ICE9-Robotics/MONA_ESP_hardware/README.md

# MONA-ESP hardware
A repo containing all the hardware files for the ESP-MONA swarm research and educational robotic platform

A full software library and examples compatible with Arduino IDE have been provided. Go to [MONA_ESP_lib](https://github.com/ICE9-Robotics/MONA_ESP_lib) to obtain the library files and installation instructions.
