ICE9-Robotics/MONA_ESP_hardware/hardware/README.md

# MONA ESP Hardware

## Schematic
The schematic for the board is given in a PDF file. The value of passive components is shown and the component code of the IC. 

## PCB design file
The PCB board file is given in [KiCad](https://www.kicad.org) format. It is neccesarry to use KiCad to open the board file.

## MONA ESP board design
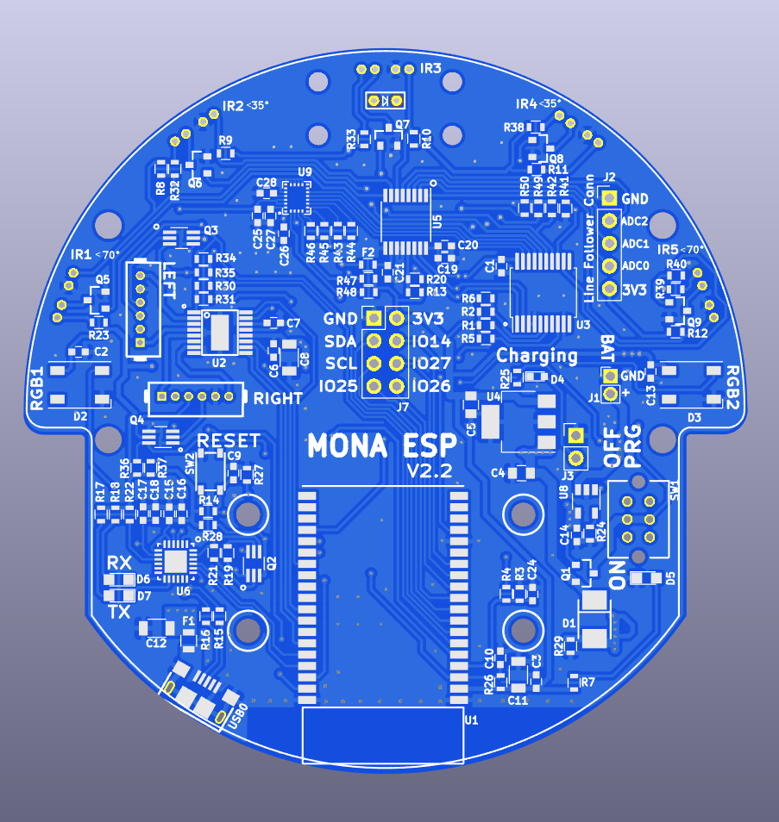
[picture p1: hardware/MONA_ESP_V2_2-Board.png]
