ICE9-Robotics/MONA_ESP_hardware/hardware/CAD/README.md

3D CAD files for the 3D printed parts of the MONA
Recommended Print Settings:
Material: PLA
Nozzle Size: 0.4 mm
Layer Height: 0.2 mm
Infill: 25%
Perimeters: 2
Support: None

Required 3D Printed Parts for 1 Mona:
- 1 x Mona Front Roller and Battery Mount
- 2 x Mona Motor Mount Base
- 2 x Mona Motor Mount Cap
- 2 x Mona Wheel
or 
- 1 x Mona All Parts
