ICE9-Robotics/MONA_ESP_hardware/hardware/CAD/Mona Assembly Printing File.3mf

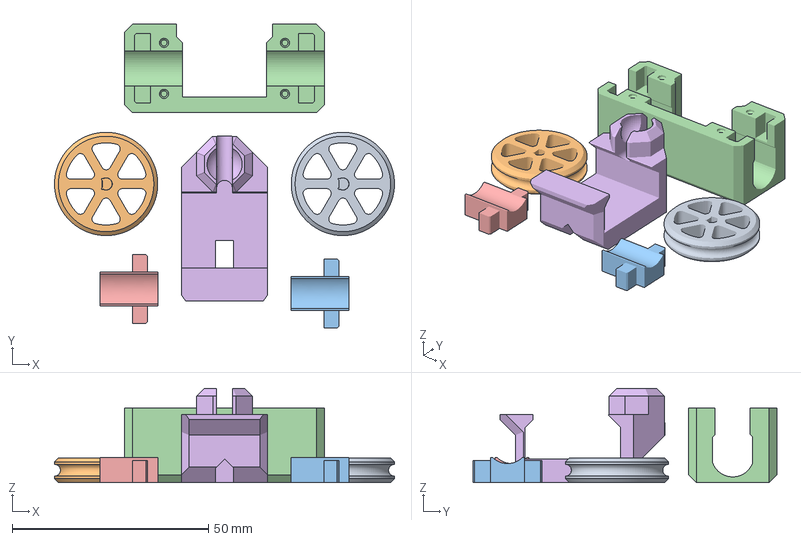
[picture p2: CAD file, 2025-12-02]
hardware/CAD/Mona Assembly Printing File.3mf
86.6 x 77.3 x 24.0 mm
Mona Wheel.stl x 2
Mona Motor Mount Cap.stl x 2
Mona Motor Mount Base.stl
Mona Front Roller and Battery Mount.stl
