ICE9-Robotics/MONA_ESP_hardware/hardware/CAD/Mona Motor Mount Base.stl

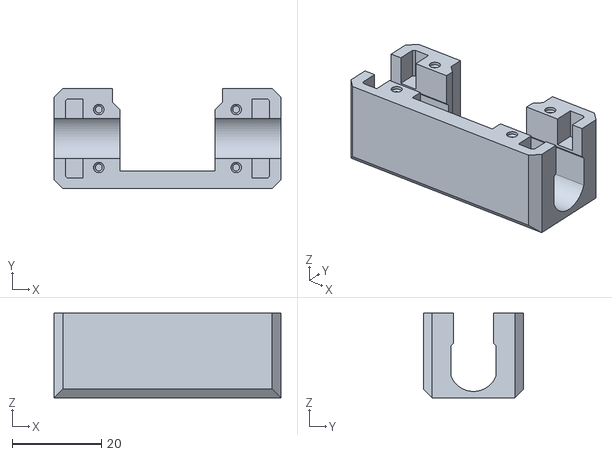
[picture p3: CAD file, 2025-12-02]
hardware/CAD/Mona Motor Mount Base.stl
50.9 x 22.5 x 19.0
