ICE9-Robotics/MONA_ESP_hardware/hardware/CAD/Mona Motor Mount Cap.stl

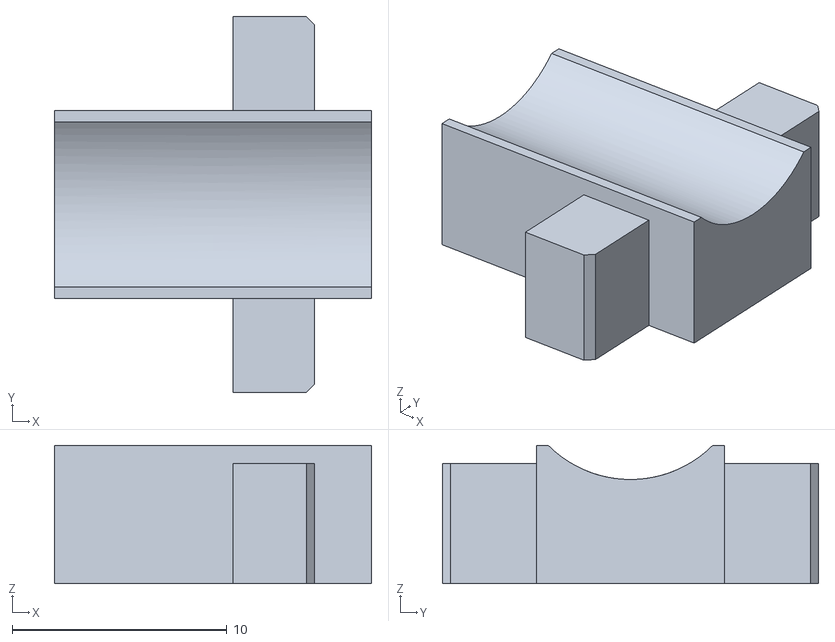
[picture p4: CAD file, 2025-12-02]
hardware/CAD/Mona Motor Mount Cap.stl
14.8 x 17.5 x 6.44
