ICE9-Robotics/MONA_ESP_hardware/hardware/CAD/Mona Wheel.stl

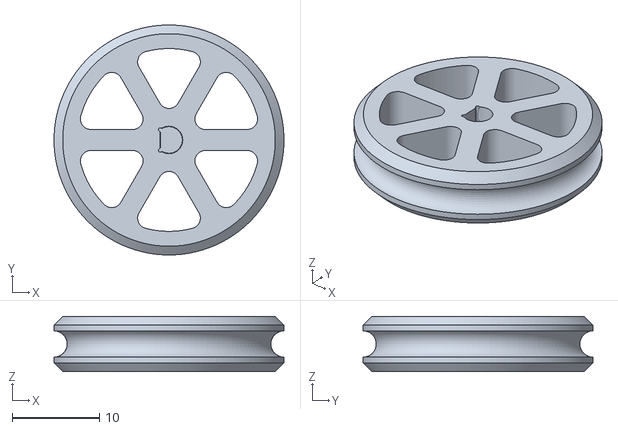
[picture p5: CAD file, 2025-12-02]
hardware/CAD/Mona Wheel.stl
26.3 x 26.3 x 6.30
