ICE9-Robotics/MONA_ESP_hardware/hardware/MONA_ESP_V2_2-Schematic.pdf

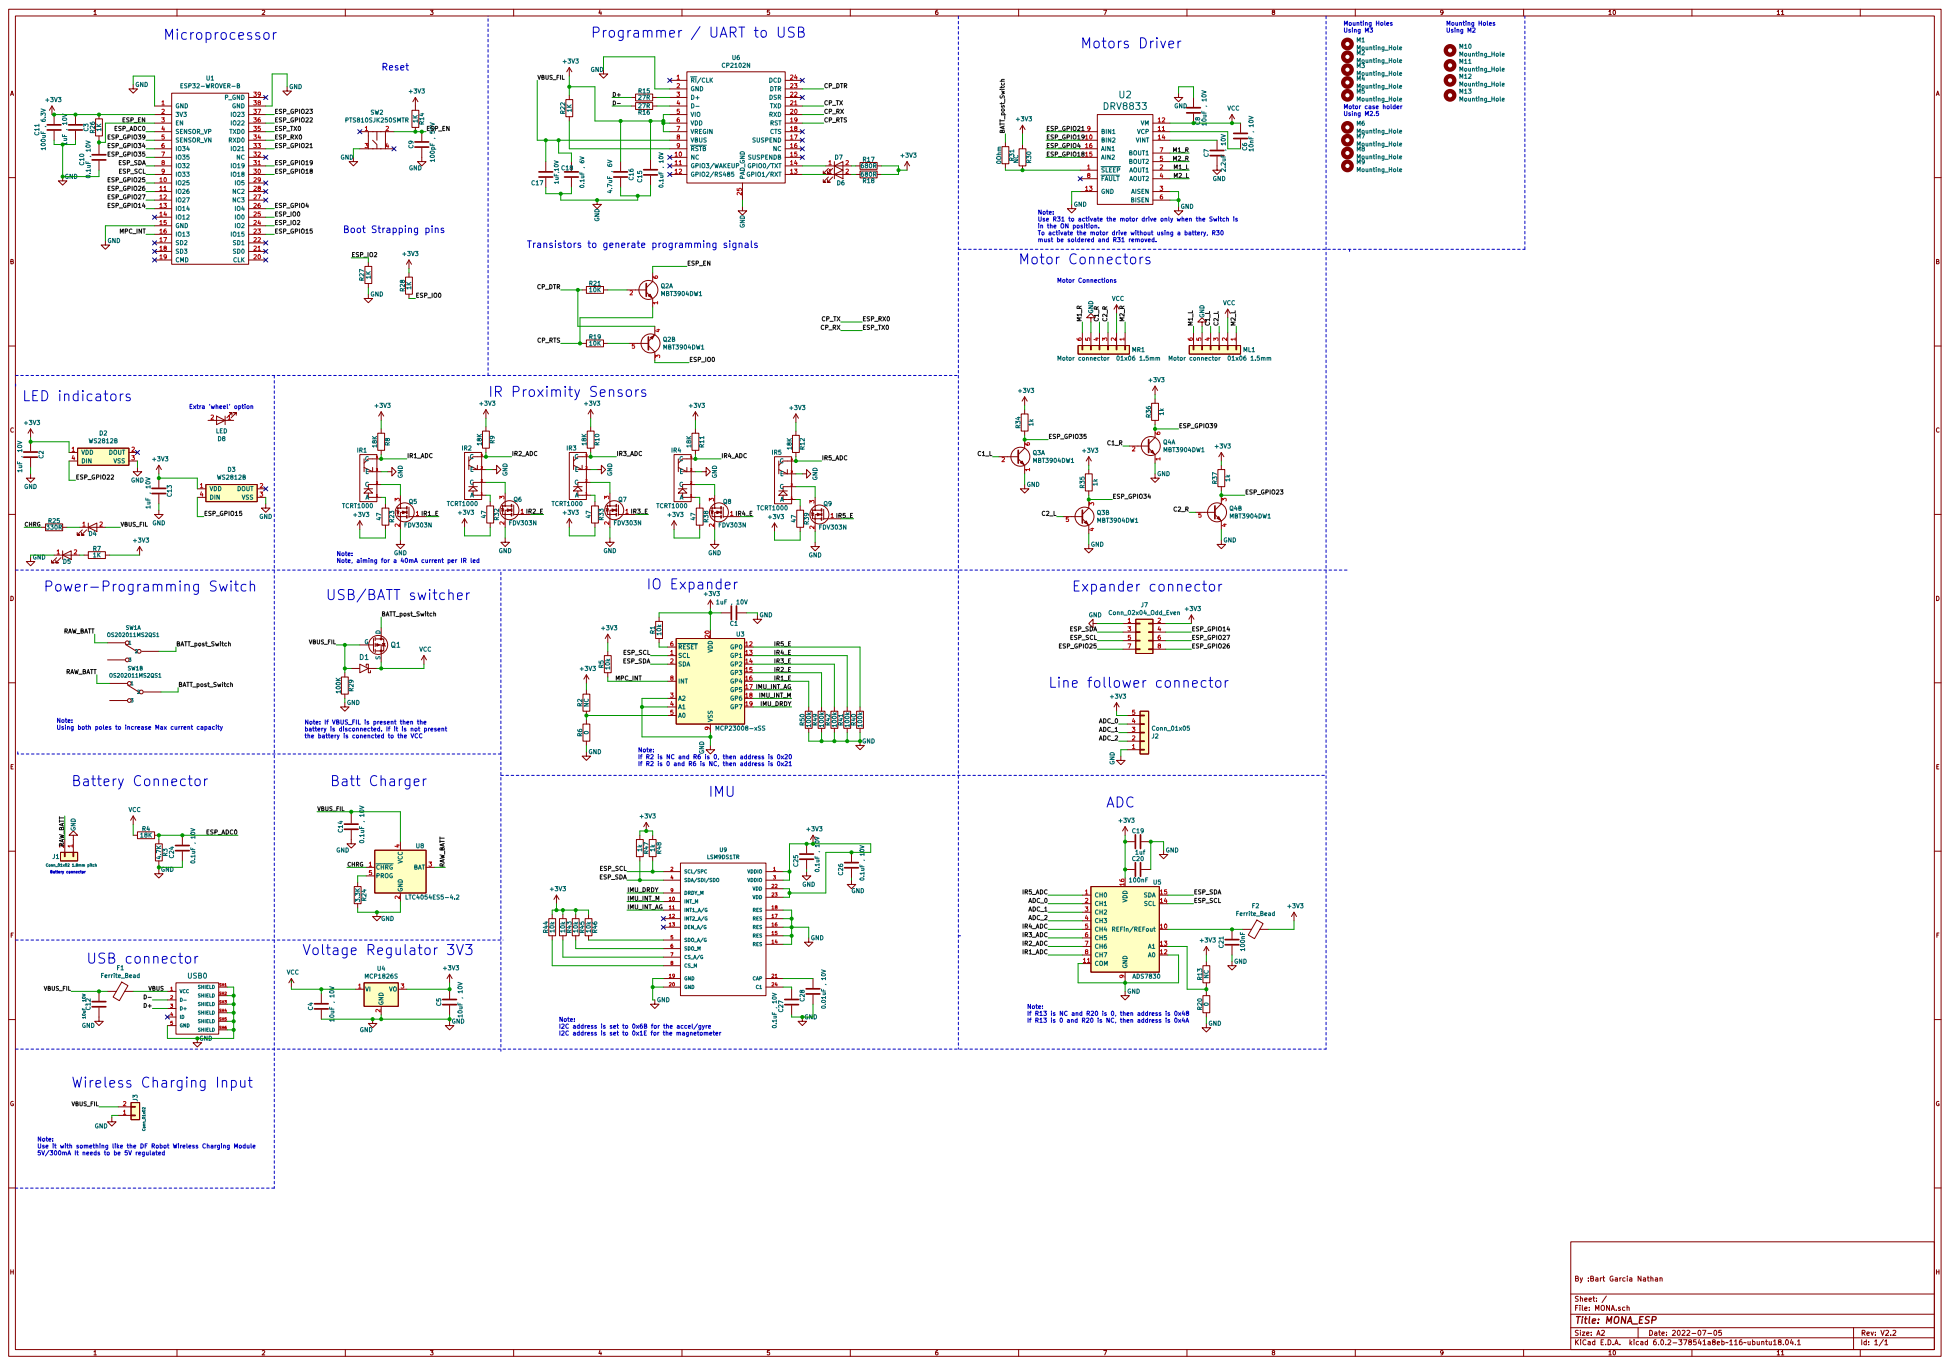
[picture p6: page 1]

Programmer / UART to USB

Note: Use R31 to activate the motor drive only when the Switch is

in the ON position.
Motor Connectors

To activate the motor drive without using a battery, R30 must be soldered and R31 removed. IO Expander

Transistors to generate programming signals

Note: Using both poles to increase Max current capacity

Note: If VBUS_FIL is present then the
battery is disconnected. If it is not present
the battery is conencted to the VCC

Note:
If R2 is NC and R6 is 0, then address is 0x20
If R2 is 0 and R6 is NC, then address is 0x21

If R13 is NC and R20 is 0, then address is 0x48
If R13 is 0 and R20 is NC, then address is 0x4A

I2C address is set to 0x6B for the accel/gyre
I2C address is set to 0x1E for the magnetometer

Note: Use it with something like the DF Robot Wireless Charging Module

5V/300mA It needs to be 5V regulated

File: MONA.sch Sheet: / By :Bart Garcia Nathan
