ICE9-Robotics/MONA_ESP_hardware/hardware/PCB_Design/MONA_ESP_V2_2.kicad_pcb

## KiCad design hardware/PCB_Design/MONA_ESP_V2_2.kicad_pcb (2022-07-05)

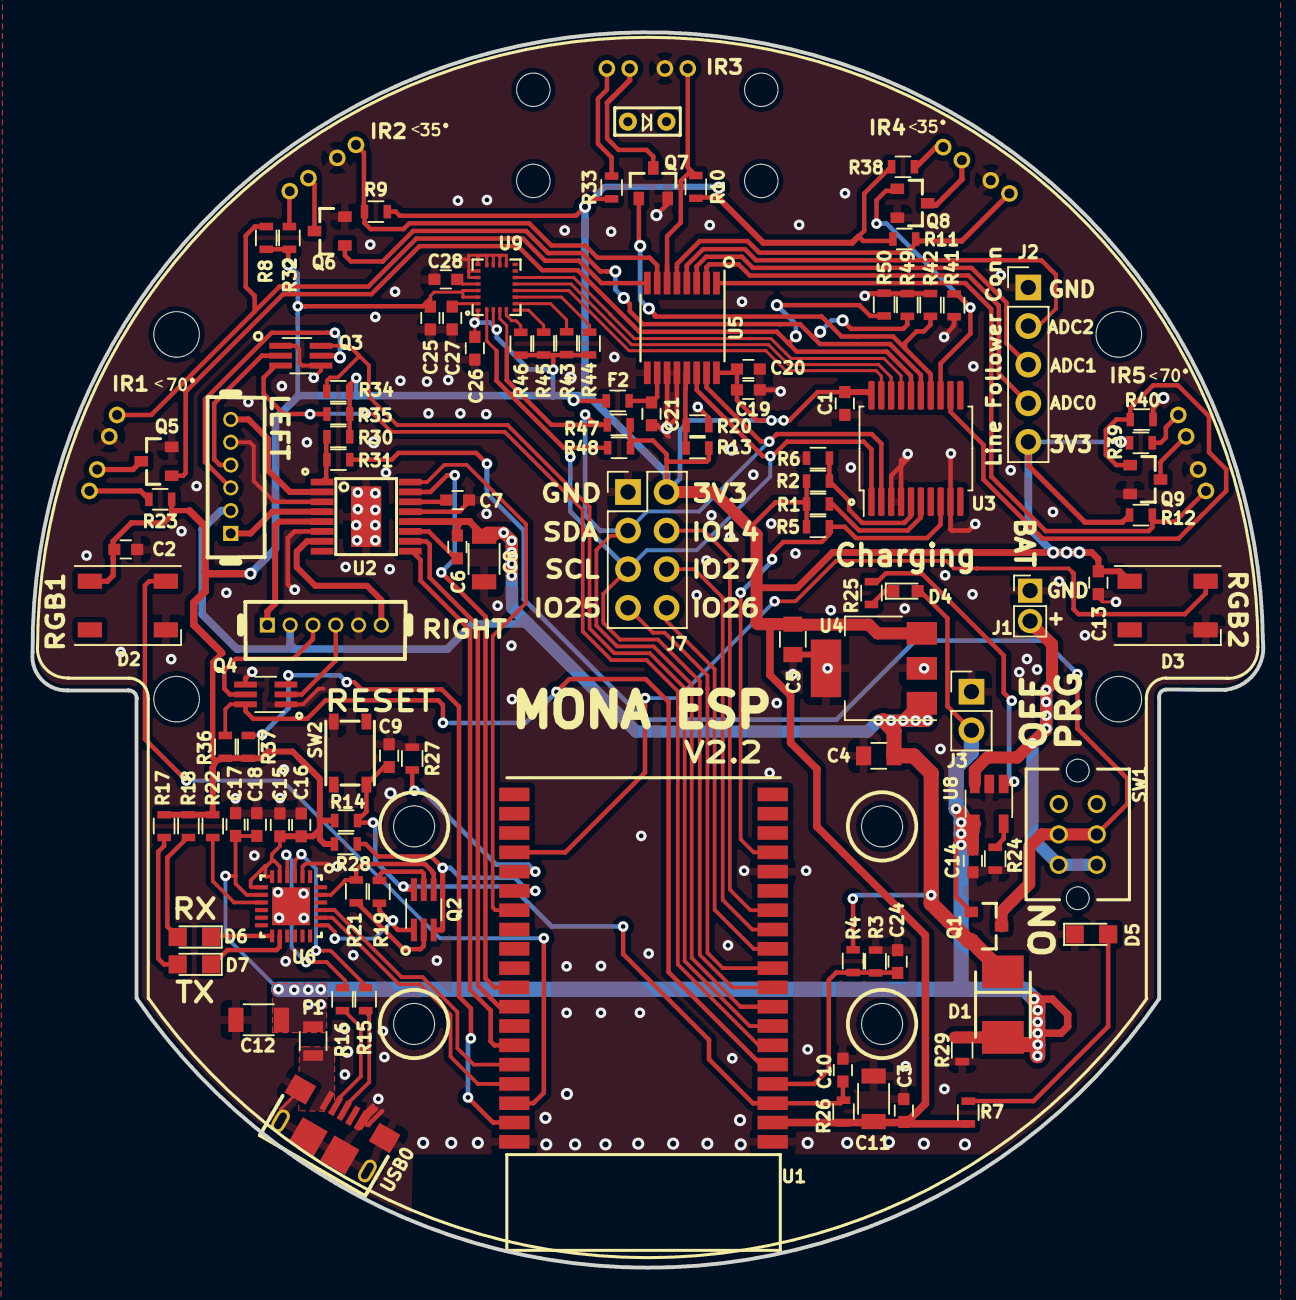
[picture p7: board MONA_ESP_V2_2.kicad_pcb from above]

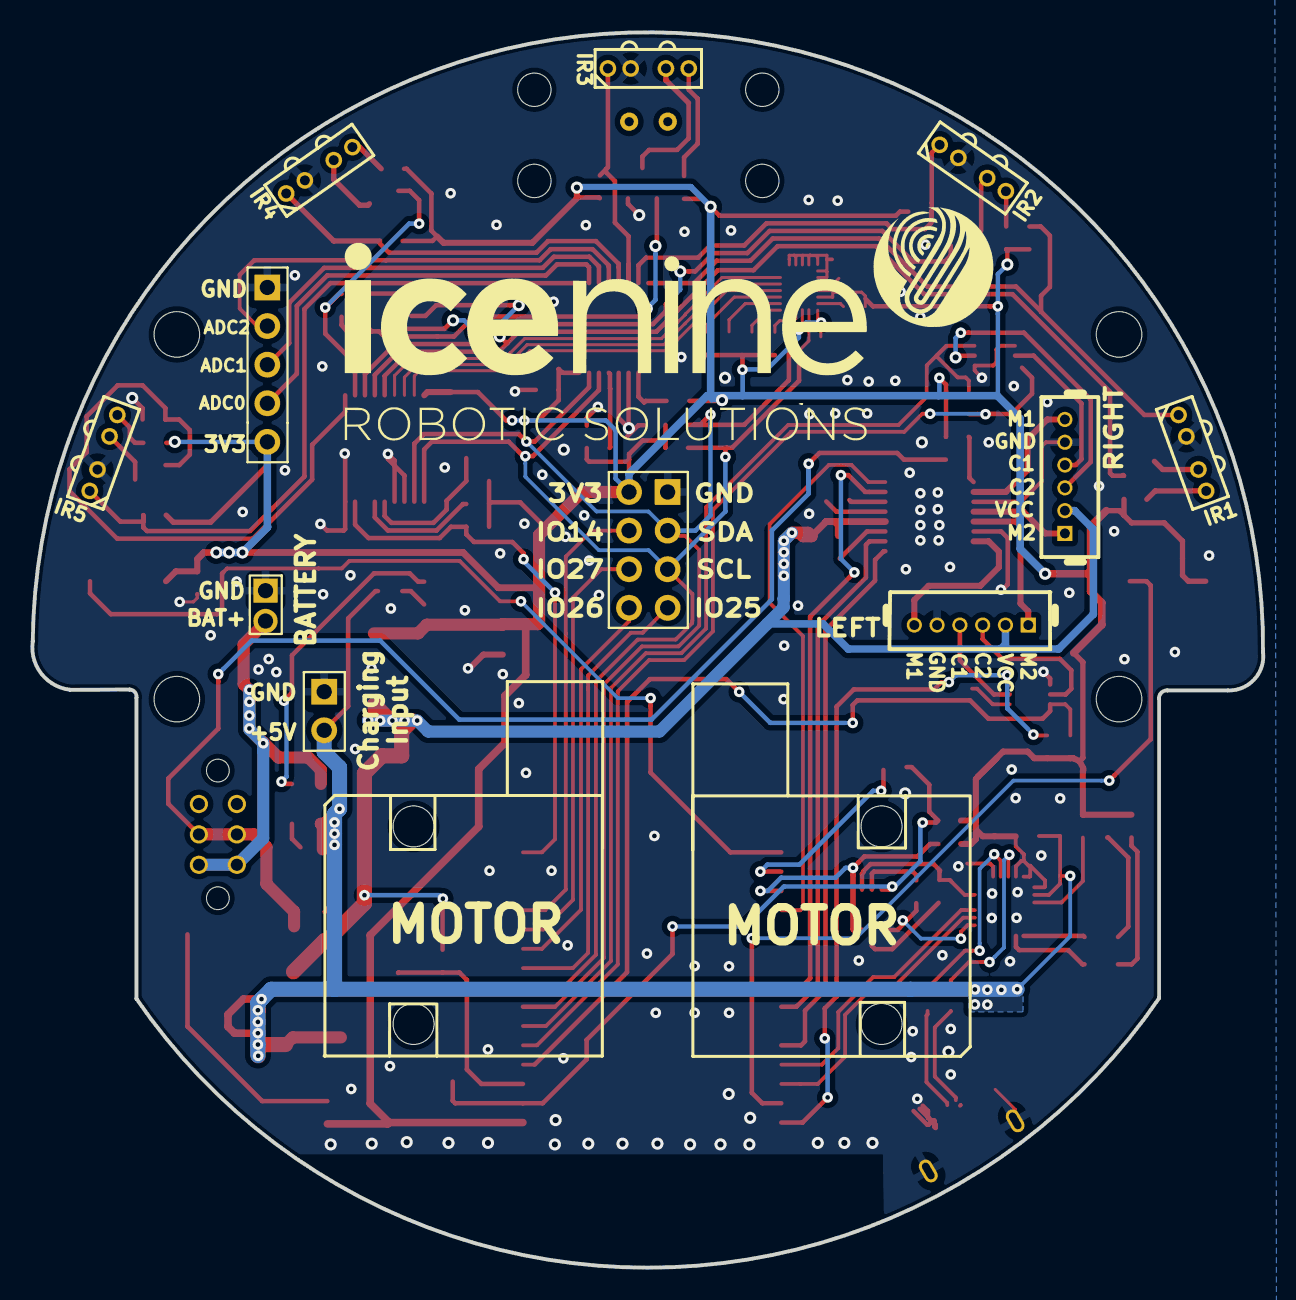
[picture p8: board MONA_ESP_V2_2.kicad_pcb from below]

Board: 2 copper layers, 81.0 x 81.3 mm, 129 parts (5 on the bottom side), 94 nets.

Parts:
C1, C2, C3, C13: 1uF , 10V; C_0603
C4, C5: 10uF , 10V; C_0805
C6: 10nF , 10V; C_0603
C7: 2.2uF , 10V; C_0603
C8, C12: 10uF , 10V; C_1206
C9: 100pF , 50V; C_0603
C10, C14, C15, C24, C25, C26, C27: 0.1uF , 10V; C_0603
C11: 100uF , 6.3V; C_1206
C16: 4.7uF , 6V; C_0603
C17: 1uF,10V; C_0603
C18: 0.1uF , 6V; C_0603
C19: 1uf; C_0603
C20, C21: 100nF; C_0603
C28: 0.01uF , 10V; C_0603
D1: Schottky_403A; SMB_403A
D2, D3: WS2812B; LED_WS2812B-PLCC4
D4: LED; LED_0603
D5, D6, D7, D8: LED; LED_0805
F1: Ferrite_Bead; L_0805
F2: Ferrite_Bead; L_0603
IR1, IR2, IR3, IR4, IR5: TCRT1000
J1: Conn_01x02 1.8mm pitch; BAT_conn_1x02_Pitch1.8mm
J2: Conn_01x05; Pin_Header_Straight_1x05_Pitch2.54mm
J3: Conn_01x02; Pin_Header_Straight_1x02_Pitch2.54mm
J7: Conn_02x04_Odd_Even; Pin_Header_Straight_2x04_Pitch2.54mm
M1, M2, M3, M5: Mounting_Hole; MountingHole_3mm
M6, M7, M8, M9: Mounting_Hole; MountingHole_2.7mm_M2.5
M10, M11, M12, M13: Mounting_Hole; MountingHole_2.2mm_M2
ML1: Motor connector 01x06 1.5mm; Pin_Header_Straight_1x06_Pitch1.27mm
MR1: Motor connector 01x06 1.5mm; Pin_Header_Straight_1x06_Pitch1.27mm
Q1: CPH3348-TL-W; SOT-23
Q2, Q3, Q4: MBT3904DW1; SOT-363_SC-70-6_Handsoldering
Q5, Q6, Q7, Q8, Q9: FDV303N; SOT-23
R1, R5, R43, R44, R45, R46: 10k; R_0603
R2, R13, R30: NC; R_0603
R3: 4.7K; R_0603
R4, R8, R9, R10, R11, R12: 18K; R_0603
R6, R20: 0; R_0603
R7, R14, R22, R26, R27, R28: 1K; R_0603
R15, R16: 27R; R_0603
R17, R18: 680R; R_0603
R19, R21: 10K; R_0603
R23, R32, R33, R38, R39: 47; R_0603
R24: 3.3K; R_0603
R25: 330R; R_0603
R29: 100K; R_0603
R31: 0Ohm; R_0603
R34, R35, R36, R37, R47, R48: 1k; R_0603
R40, R41, R42, R49, R50: 100k; R_0603
SW1: OS202011MS2QS1
SW2: PTS810SJK250SMTR; PTS810
U1: ESP32-WROVER-B; ESP32_WROVER_B
U2: DRV8833; HTSSOP-16
U3: MCP23008-xSS; SSOP-20_5.3x7.2mm_P0.65mm_Reduced_pads
U4: MCP1826S; SOT-223-3_TabPin2
U5: ADS7830; TSSOP-16_4.4x5mm_Pitch0.65mm
U6: CP2102N; QFN24-reduce_pads
U8: LTC4054ES5-4.2; TSOT-23-5
U9: LSM9DS1TR; LGA24-3.5X3.0MM
USB0: AMPHENOL-10118193-0001LF

Connections:
+3V3: C1.2, C2.1, C3.1, C5.2, C11.1, C13.1, C15.2, C16.1, C19.1, C20.1, C25.2, C26.2, D2.1, D3.1, F2.1, J2.5, J7.2, R1.1, R2.1, R5.1, R7.1, R8.2, R9.2, R10.2, R11.2, R12.2, R13.1, R14.2, R17.2, R18.2, R22.2, R23.1, R26.1, R28.1, R30.2, R32.1, R33.1, R34.1, R35.1, R36.1, R37.1, R38.1, R39.1, R43.2, R44.1, R45.2, R46.2, R47.2, R48.2, U1.2, U3.20, U4.3, U5.16, U6.5, U6.6, U6.7, U9.1, U9.3, U9.22, U9.23
/ADC_0: J2.4, U5.2
/ADC_1: J2.3, U5.3
/ADC_2: J2.2, U5.4
/BATT_post_Switch: Q1.3, R31.2, SW1.2, SW1.5
/C1_L: ML1.4, Q3.2
/C1_R: MR1.4, Q4.2
/C2_L: ML1.3, Q3.5
/C2_R: MR1.3, Q4.5
/CHRG: R25.2, U8.1
/CP_DTR: Q2.4, R21.2, U6.23
/CP_RTS: Q2.1, R19.1, U6.19
/CP_RX: U1.35, U6.20
/CP_TX: U1.34, U6.21
/D+: R15.1, USB0.3
/D-: R16.1, USB0.2
/ESP_ADC0: C24.2, R3.2, R4.1, U1.4
/ESP_EN: C9.2, C10.1, Q2.6, R14.1, R26.2, SW2.2, U1.3
/ESP_GPIO4: U1.26, U2.16
/ESP_GPIO14: J7.4, U1.13
/ESP_GPIO15: D3.4, U1.23
/ESP_GPIO18: U1.30, U2.15
/ESP_GPIO19: U1.31, U2.10
/ESP_GPIO21: U1.33, U2.9
/ESP_GPIO22: D2.4, U1.36
/ESP_GPIO23: Q4.3, R37.2, U1.37
/ESP_GPIO25: J7.7, U1.10
/ESP_GPIO26: J7.8, U1.11
/ESP_GPIO27: J7.6, U1.12
/ESP_GPIO34: Q3.3, R35.2, U1.6
/ESP_GPIO35: Q3.6, R34.2, U1.7
/ESP_GPIO39: Q4.6, R36.2, U1.5
/ESP_IO0: Q2.3, R28.2, U1.25
/ESP_IO2: R27.1, U1.24
/ESP_SCL: J7.5, R48.1, U1.9, U3.1, U5.14, U9.2
/ESP_SDA: J7.3, R47.1, U1.8, U3.2, U5.15, U9.4
/IMU_DRDY: U3.19, U9.9
/IMU_INT_AG: U3.17, U9.11
/IMU_INT_M: U3.18, U9.10
/IR1_ADC: IR1.4, R8.1, U5.8
/IR1_E: Q5.1, R50.1, U3.16
/IR2_ADC: IR2.4, R9.1, U5.7
/IR2_E: Q6.1, R49.1, U3.15
/IR3_ADC: IR3.4, R10.1, U5.6
/IR3_E: Q7.1, R42.1, U3.14
/IR4_ADC: IR4.4, R11.1, U5.5
/IR4_E: Q8.1, R41.1, U3.13
/IR5_ADC: IR5.4, R12.1, U5.1
/IR5_E: Q9.1, R40.1, U3.12
/M1_L: ML1.6, U2.2
/M1_R: MR1.6, U2.7
/M2_L: ML1.1, U2.4
/M2_R: MR1.1, U2.5
/MPC_INT: R5.2, U1.16, U3.8
/RAW_BATT: J1.2, SW1.1, SW1.4, U8.3
/VBUS: F1.1, USB0.1
/VBUS_FIL: C12.2, C14.2, C17.2, C18.2, D1.A, D4.2, F1.2, J3.2, Q1.1, R29.2, U6.8, U8.4
GND: C1.1, C2.2, C3.2, C4.1, C5.1, C7.1, C8.2, C9.1, C10.2, C11.2, C12.1, C13.2, C14.1, C15.1, C16.2, C17.1, C18.1, C19.2, C20.2, C21.1, C24.1, C25.1, C26.1, C27.1, C28.1, D2.3, D3.3, D5.1, IR1.3, IR2.3, IR3.3, IR4.3, IR5.3, J1.1, J2.1, J3.1, J7.1, ML1.5, MR1.5, Q3.1, Q3.4, Q4.1, Q4.4, Q5.2, Q6.2, Q7.2, Q8.2, Q9.2, R3.1, R6.2, R20.2, R24.1, R27.2, R29.1, R40.2, R41.2, R42.2, R49.2, R50.2, SW2.3, U1.1, U1.15, U1.38, U2.3, U2.6, U2.13, U3.3, U3.4, U3.9, U4.2, U5.9, U5.11, U5.12, U6.2, U6.25, U8.2, U9.14, U9.15, U9.16, U9.17, U9.18, U9.19, U9.20, USB0.5, USB0.SH1, USB0.SH2, USB0.SH3, USB0.SH4, USB0.SH5, USB0.SH6
unnamed: C6.1, U2.11
unnamed: C7.2, U2.14
unnamed: C21.2, F2.2, U5.10
unnamed: C27.2, U9.24
unnamed: C28.2, U9.21
unnamed: D4.1, R25.1
unnamed: D5.2, R7.2
unnamed: D6.1, U6.13
unnamed: D6.2, R18.1
unnamed: D7.1, U6.14
unnamed: D7.2, R17.1
unnamed: IR1.1, R23.2
unnamed: IR1.2, Q5.3
unnamed: IR2.1, R32.2
unnamed: IR2.2, Q6.3
unnamed: IR3.1, R33.2
unnamed: IR3.2, Q7.3
unnamed: IR4.1, R38.2
unnamed: IR4.2, Q8.3
unnamed: IR5.1, R39.2
unnamed: IR5.2, Q9.3
unnamed: Q2.2, R21.1
unnamed: Q2.5, R19.2
unnamed: R1.2, U3.6
unnamed: R2.2, R6.1, U3.5
unnamed: R13.2, R20.1, U5.13
unnamed: R15.2, U6.3
unnamed: R16.2, U6.4
unnamed: R22.1, U6.9
unnamed: R24.2, U8.5
unnamed: R30.1, R31.1, U2.1
unnamed: R43.1, U9.7
unnamed: R44.2, U9.8
unnamed: R45.1, U9.6
unnamed: R46.1, U9.5
VCC: C4.2, C6.2, C8.1, D1.K, ML1.2, MR1.2, Q1.2, R4.2, U2.12, U4.1
