ICE9-Robotics/MONA_ESP_hardware/(commit log)

2021-01-13 ADD Hardware Files
    Add Schematic in PDF, board in Kicad-board file and image
    [MONA_ESP_V1_0.kicad_pcb]
2021-01-13 Update Software Readme
    The software lives in its own repo, which is a limitation imposed by the arduino installation process. Point in a ReadMe how to access the software repo.
2021-01-13 Update README.md
    Wrong link for the Board Image
2022-07-05 Add MONA_ESP V2.2
    Add Schematic, board design file and front PCB render
    [MONA_ESP_V2_2.kicad_pcb]
2024-07-31 CAD File Update
    New Revision of the CAD files and added recommended print settings
    [Bottom_Bracket_Big_13.stl, Front_Carriage v4.stl, Mona Motor Mount Base.stl, Mona Motor Mount Cap.stl, Top_Bracket_Big_13.stl, Wheel.stl]
2024-08-19 Design update to give clearance for motor encoders with through hole connector
    [Mona Motor Mount Base.stl, Mona Motor Mount Cap.stl]
2025-12-02 Replacements for existing models
    [Mona Motor Mount Base.stl, Mona Motor Mount Cap.stl, Mona Wheel.stl]
2025-12-02 Adds .3mf file for printing directly in slicer
    Each body is an individual instance, which can be edited/modified/removed/duplicated prior to printing.
    [Mona Assembly Printing File.3mf]
